RR-CREATOR/Veloce/PCB/PCB_README.md

This is a custom heatbed pcb

its size is 256x256

mounting holes are m3 and at a distance of 8mm from edges.

Resistance is about 3.3-3.5ohms, and it can handle abt 7.2amps current.

it can give rise of about 110 celsius temp, and consumes abt 160-170W power
