RR-CREATOR/Veloce/Bill of Material.xlsx

Item | Quantity | Price ($) | Total | Link | Notes | Alternate links
Printhead
Hotend | 1 | 12 | 12 |  | TZ-E3 2.0 clone/og???? idk but it has sm specs ig (max 33 flow rate)
Custom Sherpa Micro | 1 | 10 | 10 |  | Using Bmg internals and motor
5015 Blower | 2 | 1.43 | 2.86 | https://robu.in/product/6028-24vdc-0-1a-turbo-blower-cooling-fan/ | For cooling prints
4010 Cooling Fan | 1 | 0.81 | 0.81 | https://novo3d.in/cooling-fan-6015/?attribute_type=24V | One is for motherboard and one for heatbreak
BTT Klicky D2H V1.0 | 1 | 5 | 5 |  | Klicky klick klick | https://www.zee3d.in/shipping-and-returns
ADXL345 generic accelerometer | 1 | 1.27 | 1.27 | https://robu.in/product/adxl345-tripple-axis-accelerometer-board/?gad_source=1 | For input shaping
Control n Power
24V 20A 480W PSU | 1 | 25 | 25 |  | Getting from local shop, so no link
Main Control Board | 1 | 30 | 30 |  | Can support upto 6 motors, need it as using double z. Also it works at supr high speeds
6015 Cooling Fan | 1 | 0.81 | 0.81 | https://novo3d.in/cooling-fan-6015/?attribute_type=24V | For motherboard
Frame
500mm 3030 4T extrusion | 12 | 2 | 24 |  | Aluminium extrusions for frame
500mm 2020 4T extrusion | 1 | 1.6 | 1.6 |  | For supporting X axis
Linear rails for x and y axis | 3 | 8 | 24 |  | 40cm mgn12h with block [Couldnt find cheaper :( ]
3030 corner right joint | 16 | 0.68 | 10.88 |  | Corner joints, place holders as would be using other attachers, but price would be sm roughly
Linear Rods | 4 | 1.5 | 6 |  | 400mm linear rods, 8mm dia
Lead Screw 30cm | 2 | 1.8 | 3.6 |  | 2 lead screws as am gonna make a double z axis for better quality and adjustment
Motors
Nema 17 for X and Y (5.5) | 2 | 10 | 20 |  | 5.5kgcm nema 17 with low inductance for high speed and accel | https://dc3d.in/shop/voron-v2-4-parts/ldo-nema-17-stepper-motor-ldo-42sth48-2504ac/
Nema 17 Z axis and extruder (4.4) | 2 | 4 | 8 |  | 4.4kgcm Nema 17 for Z axis and extruder
BTT TMC2209 V1.3 | 0 | 4.33 | 0 |  | Drivers for motors
Kinematics
GT2 Timing Pulley x2 | 1 | 1.33 | 1.33 | https://robu.in/product/aluminum-gt2-timing-pulley-for-6mm-belt-20-tooth-5mm-bore-2pcs/ | For corexy
GT2 Idler Pulley x2 | 3 | 1.68 | 5.04 | https://robu.in/product/aluminum-gt2-timing-idler-pulley-6mm-belt-20-tooth-5mm-bore-2pcs/ | For corexy
GT2 Smooth Pulley x2 | 2 | 1.19 | 2.38 | https://robu.in/product/2pcs-x-gt2-aluminium-pulley-without-20-teeth-5mm-bore-6mm-belt/ | For corexy
GT2 6mm Timing Belt | 1 | 4 | 4 |  | For corexy
Coupler | 2 | 4.33 | 8.66 |  | Couplers for screw and nema 17
Linear Bearings 8mm | 4 | 0.45 | 1.8 | https://robu.in/product/lm8uu-8-mm-linear-bearings-linear-motion-bearing/ | Bearings for linear rods
Other/Misc.
Heatbed | 1 | 15 | 15 |  | CUSTOM PCB
Printbed | 1 | 5 | 5 |  | Magnetic print bed
M4 40mm Screws | 6 | 0.16 | 0.96 |  | M4 countersunk screws to screw in heatbed
Spacer Springs x4 | 1 | 1 | 1 |  | Springs to allow for manual levelling and providing space
Wing Nut x10 | 1 | 1.03 | 1.03 |  | Wing nut for screws, easier to adjust bed
Aluminium Sheet for base carriage (25x25x3) | 1 | 5.85 | 5.85 |  | Aluminium sheet for better heat distribution below bed, and for giving rigidity
Cork Sheet | 1 | 5.48 | 5.48 |  | Cork sheet as heat inslutor to prevent petg bed mount from melting ;)
MISC NUTS | 1 | 10 | 10 |  | nuts
MISC SCREWS | 1 | 10 | 10 |  | screws
 | Final: | 263.36
