RR-CREATOR/Veloce/(commit log)

2025-04-17 Update and rename temp.md to PCB_README.md
2025-04-17 Create Printer v19.f3z
2025-04-17 Rename Printer v19.f3z to Printer.f3z
    [Printer.f3z]
